RalphWystup/Analoganzeige-optisch-lesen-mit-ESP32-S3/bildsatz/0p70.jpg

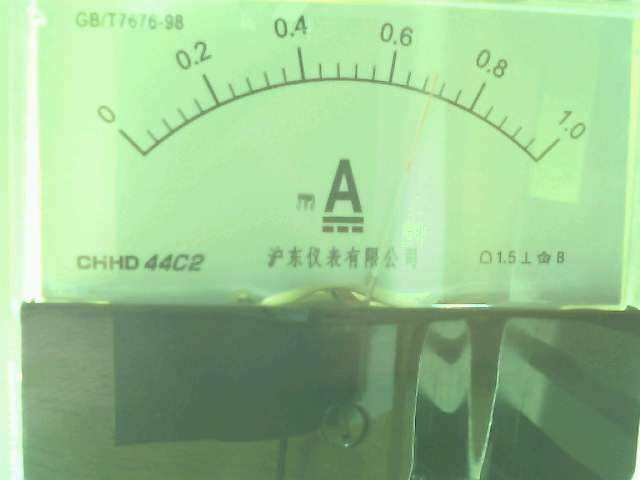
bildsatz/0p70.jpg
