RalphWystup/Analoganzeige-optisch-lesen-mit-ESP32-S3/(commit log)

2026-09-30 Analoganzeige optisch lesen: ein ESP32-S3 liest ein Zeigerinstrument
    Die Kamera sieht die Skala in jedem Bild neu: Bogen und Striche per RANSAC,
    der Zeiger als Gerade, der Wert am Schnittpunkt — ohne festen Drehpunkt und
    ohne Einlernen. Manuskript, Seite mit der Erkennung als JavaScript und dem
    Bildsatz vom Geraet als Nachweis.
2026-09-30 Angaben fuer Zenodo
    Titel, Beschreibung, Schlagwoerter, Lizenz und Verweise, damit beim Archivieren
    nichts von Hand eingetippt werden muss.
2026-09-30 Kopfangaben fuer Suchmaschinen
    Kurzbeschreibung, kanonische Adresse, Vorschauangaben fuer geteilte Links und
    Strukturdaten nach schema.org — in der Seite und in der Weiterleitung. Die
    Angaben stammen aus derselben Quelle wie Startseite und Sitemap.
2026-09-30 Zitierangabe
    CITATION.cff: GitHub zeigt damit den Knopf "Cite this repository" mit fertigem
    Zitat, und Literaturverwaltungen koennen die Angabe auslesen. Ohne DOI und ohne
    Dritte.
